Steven-qt/UM_Olivia_2025/latar.png

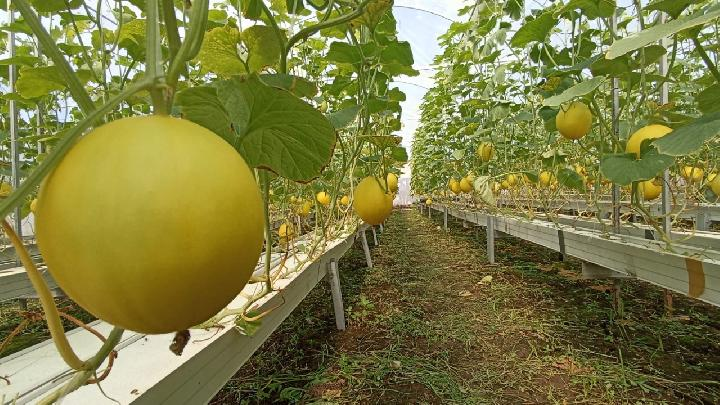
latar.png
