Steven-qt/UM_Olivia_2025/README.md

# Berikut ini adalh link video dan dokumentasi 
### link video Demo
https://drive.google.com/file/d/1mi_WNd50WIqh7WD49KStsjeP0DAE_DWx/view?usp=sharing (VIDEO)

### link Dokumentasi Teknis
https://drive.google.com/file/d/1HRz2FUBU_fLUM6sUgmy33b_ke_D2CjJ-/view?usp=drive_link (TEKNIS)
